PandaGuGu/stm32-health-monitor/board/schematic.md

# 接线与原理图

> 组件清单图见 [组件部分.png](./组件部分.png)；精修系统原理图见
> [docs/schematic/系统原理图_v1.1.svg](../docs/schematic/系统原理图_v1.1.svg)（[引脚分配表](../docs/schematic/系统原理图_v1.1.md)）。
> 本文件给出逐引脚接线表与一张供快速对照的 Mermaid 图。

## 1. 接线表

全部器件 **3.3V** 逻辑与供电，共地。

| 器件 | 引脚 | → STM32F103C8T6 | 备注 |
|---|---|---|---|
| **MAX30102** 心率血氧 | VCC | 3.3V | |
| | GND | GND | |
| | SCL | PB7 | 软件 I2C 时钟 |
| | SDA | PB8 | 软件 I2C 数据 |
| | INT | PB9 | 轮询（非中断）采样就绪 |
| **0.96" OLED** | VCC | 3.3V | SSD1306 |
| | GND | GND | |
| | SCK | PA5 | 软件 SPI/I2C 时钟 |
| | SDA | PA6 | 数据 |
| **MPU6050** 姿态 | VCC | 3.3V | |
| | GND | GND | |
| | SCL | PB10 | 硬件 I2C2 时钟 |
| | SDA | PB11 | 硬件 I2C2 数据 |
| **DS18B20** 温度 | VCC | 3.3V | |
| | GND | GND | |
| | DQ | PA8 | 单总线，需上拉 |
| **蜂鸣器**（有源） | VCC | 3.3V | |
| | GND | GND | |
| | I/O | PA12 | GPIO 高电平驱动 |
| **ESP32-WROOM-32** 信息节点 | VIN | 5V 或 3.3V | 板载 AMS1117，按模块实际标注接 |
| | GND | GND | 与 STM32 共地，串口通信的必要条件 |
| | GPIO16 (RX2) | ← PA9 | STM32 `USART1_TX` |
| | GPIO17 (TX2) | → PA10 | STM32 `USART1_RX` |

> **注意**：`PA12` 同时是 USB_DP。作 GPIO 使用后蓝板 USB 口不再用于 USB 通信（烧录用 SWD/JLINK 即可）。
> ESP32 只接三根线（TX / RX / GND），不共地时串口收到的全是乱码。

## 2. 系统连线（Mermaid）

```mermaid
flowchart LR
    subgraph Sensors["传感器 / 外设"]
        HR["MAX30102<br/>心率 · 血氧"]
        IMU["MPU6050<br/>姿态 · 跌倒"]
        TEMP["DS18B20<br/>体温"]
        BUZ["蜂鸣器<br/>报警"]
        LCD["0.96寸 OLED<br/>显示"]
    end

    subgraph MCU["STM32F103C8T6 蓝板"]
        I2C2["硬件 I2C2"]
        SWI["软件 I2C"]
        OW["1-Wire"]
        GPIO["GPIO"]
        POLL["INT 轮询"]
        U1["USART1<br/>PA9 / PA10"]
    end

    ESP["ESP32-WROOM-32<br/>信息节点"]

    HR -- "SCL=PB7 / SDA=PB8" --> SWI
    HR -- "INT=PB9" --> POLL
    IMU -- "SCL=PB10 / SDA=PB11" --> I2C2
    TEMP -- "DQ=PA8 + 4.7k 上拉" --> OW
    LCD -- "SCK=PA5 / SDA=PA6" --> SWI
    BUZ -- "I/O=PA12" --> GPIO
    U1 -- "TX/RX 115200<br/>GPIO16 / GPIO17" --> ESP
    ESP -- "BLE · WiFi · HTTP" --> NET(["App / 中继"])
```

## 3. 电源与信号完整性

- 供电：5V（USB/面包板）→ 蓝板 AMS1117 → **3.3V**，整机功耗约 50–80mA 典型，蜂鸣器按 20–30mA 计入，余量充足。
- 上拉：两条软件 I2C（PB7/PB8、PA5/PA6）与 DS18B20 DQ 需 4.7kΩ 上拉；多数成品模块已板载，**搭板前需核实**。
- 蜂鸣器若为无源（需 PWM 频率驱动），PA12 无定时器通道，需改接到 TIM 通道引脚（如 PA8/PA9/PA10 等），本工程按有源蜂鸣器编写。

## 4. 硬件搭建前确认清单

- [x] OLED 是 4 针(I2C) 还是 7 针(SPI)，驱动是否匹配 —— 实测为 I2C 模块，驱动匹配（`DST-015-D`，已加 ~2µs 底层延时后稳定）
- [x] 蜂鸣器有源/无源 —— 实测为**有源**（PA12 直接驱动，开机短鸣两声可闻）
- [x] 各模块板载上拉是否存在 —— MPU6050 有；OLED 有；MAX30102/DS18B20 待补（前者未接通、后者用内部 IPU 兜底）
- [ ] 蓝板晶振（8MHz HSE）与固件 `system_stm32f10x.c` 配置一致（本工程按 72MHz 主频）
