PandaGuGu/stm32-health-monitor/board/组件部分.png

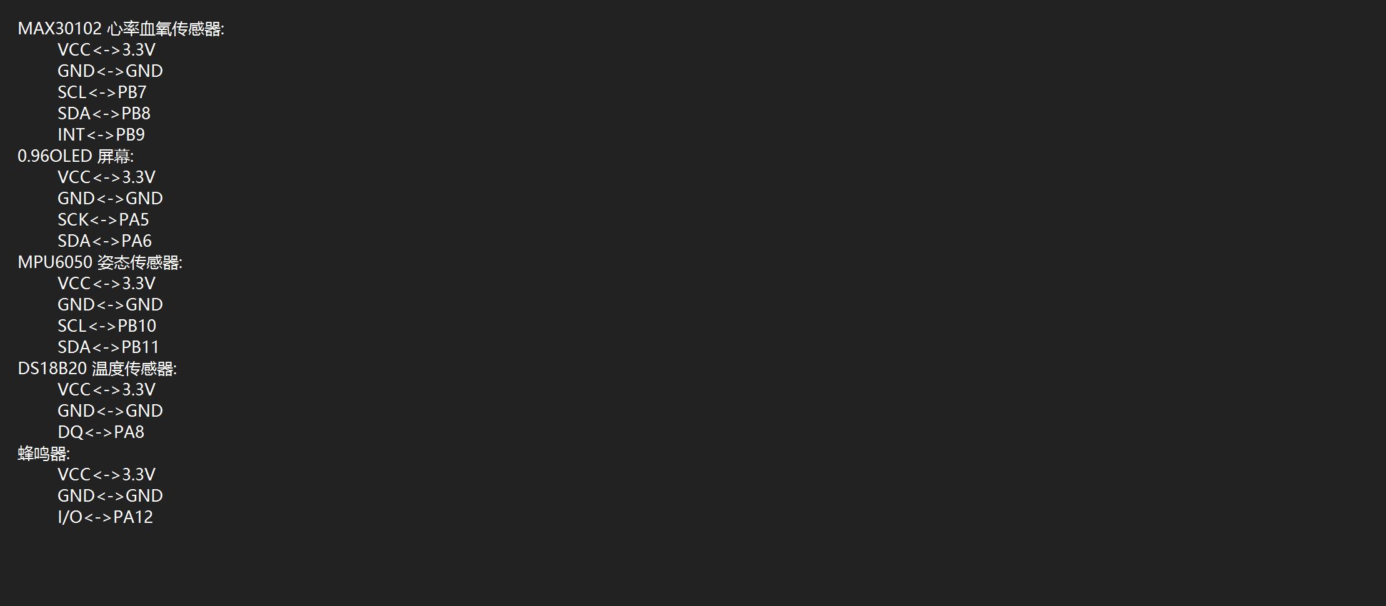
board/组件部分.png
