PandaGuGu/stm32-health-monitor/docs/esp32/app-mumu-1.png

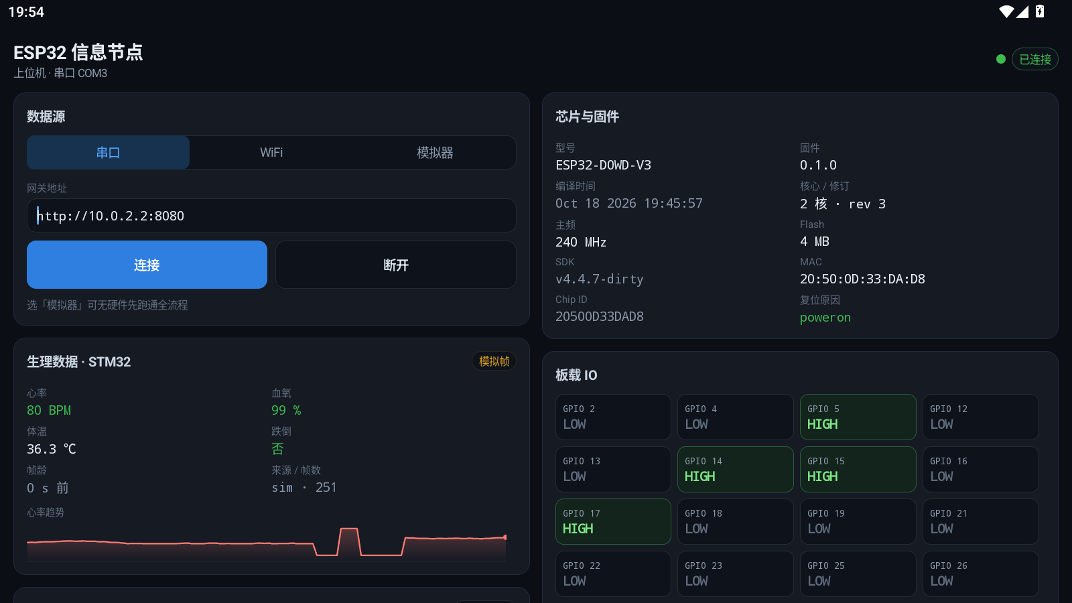
docs/esp32/app-mumu-1.png
