PandaGuGu/stm32-health-monitor/docs/esp32/app-mumu-2.png

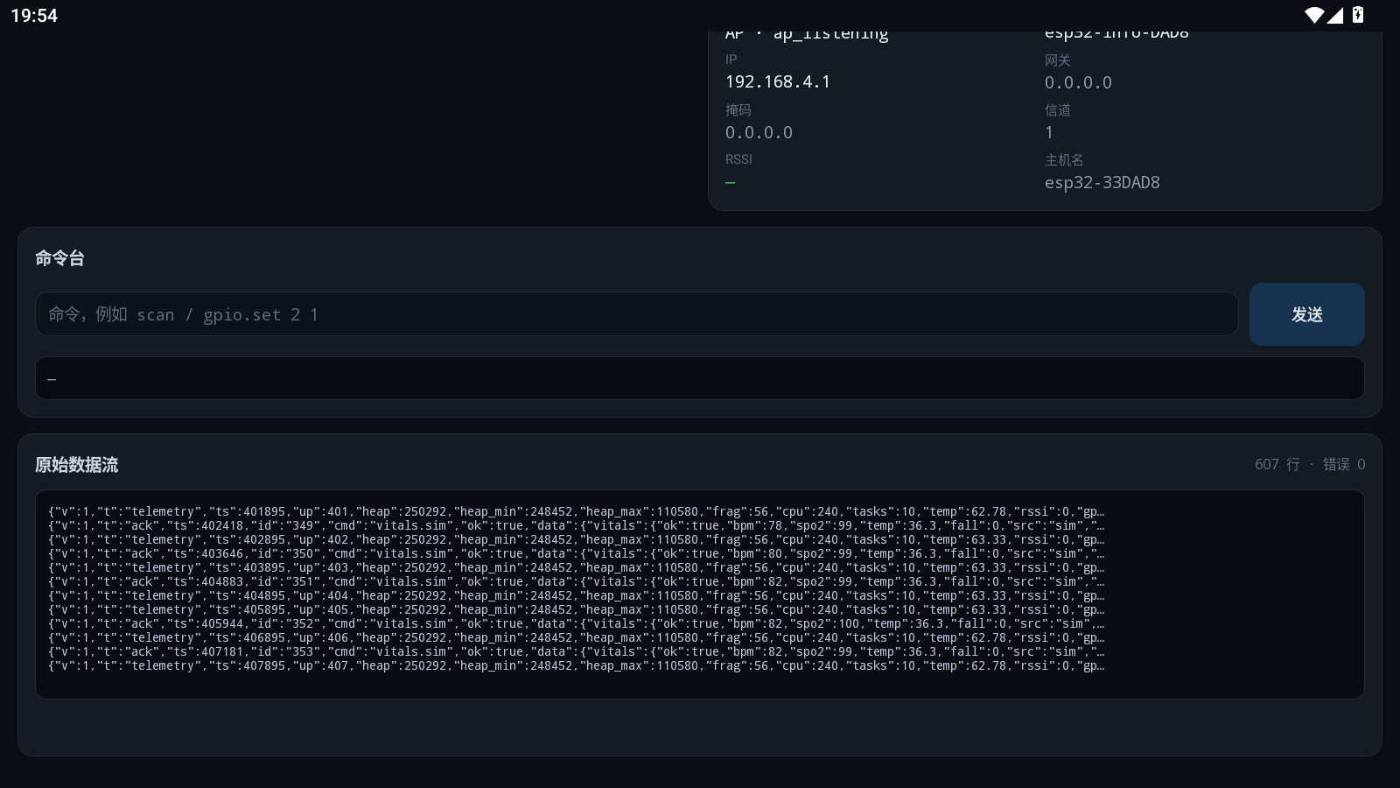
docs/esp32/app-mumu-2.png
