PandaGuGu/stm32-health-monitor/docs/esp32/app-mumu-wifi.png

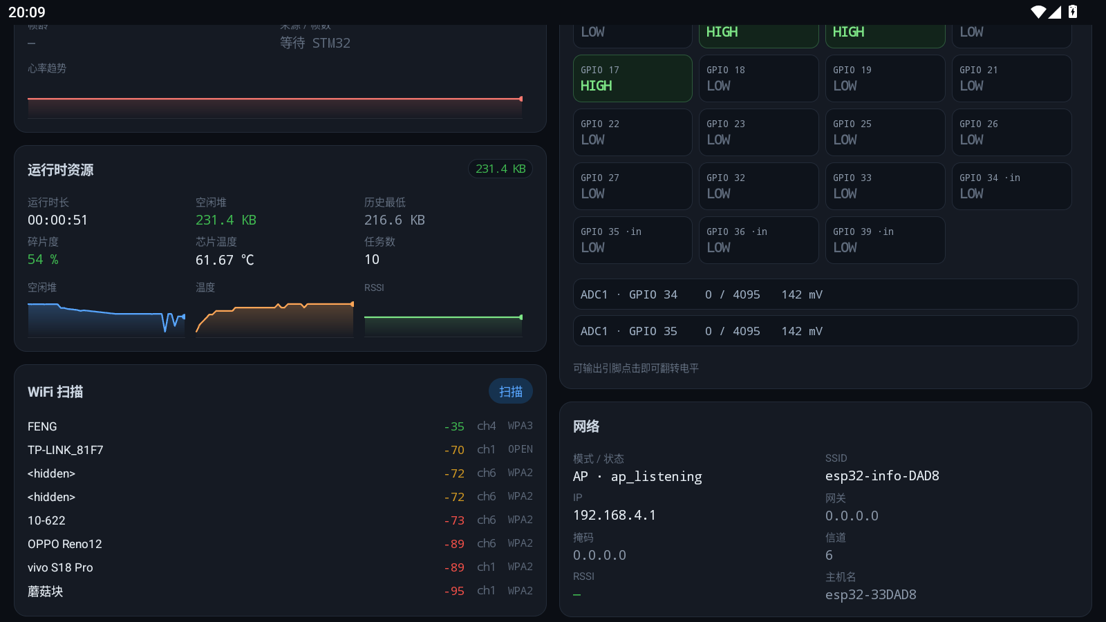
docs/esp32/app-mumu-wifi.png
