PandaGuGu/stm32-health-monitor/docs/esp32/web-dashboard.png

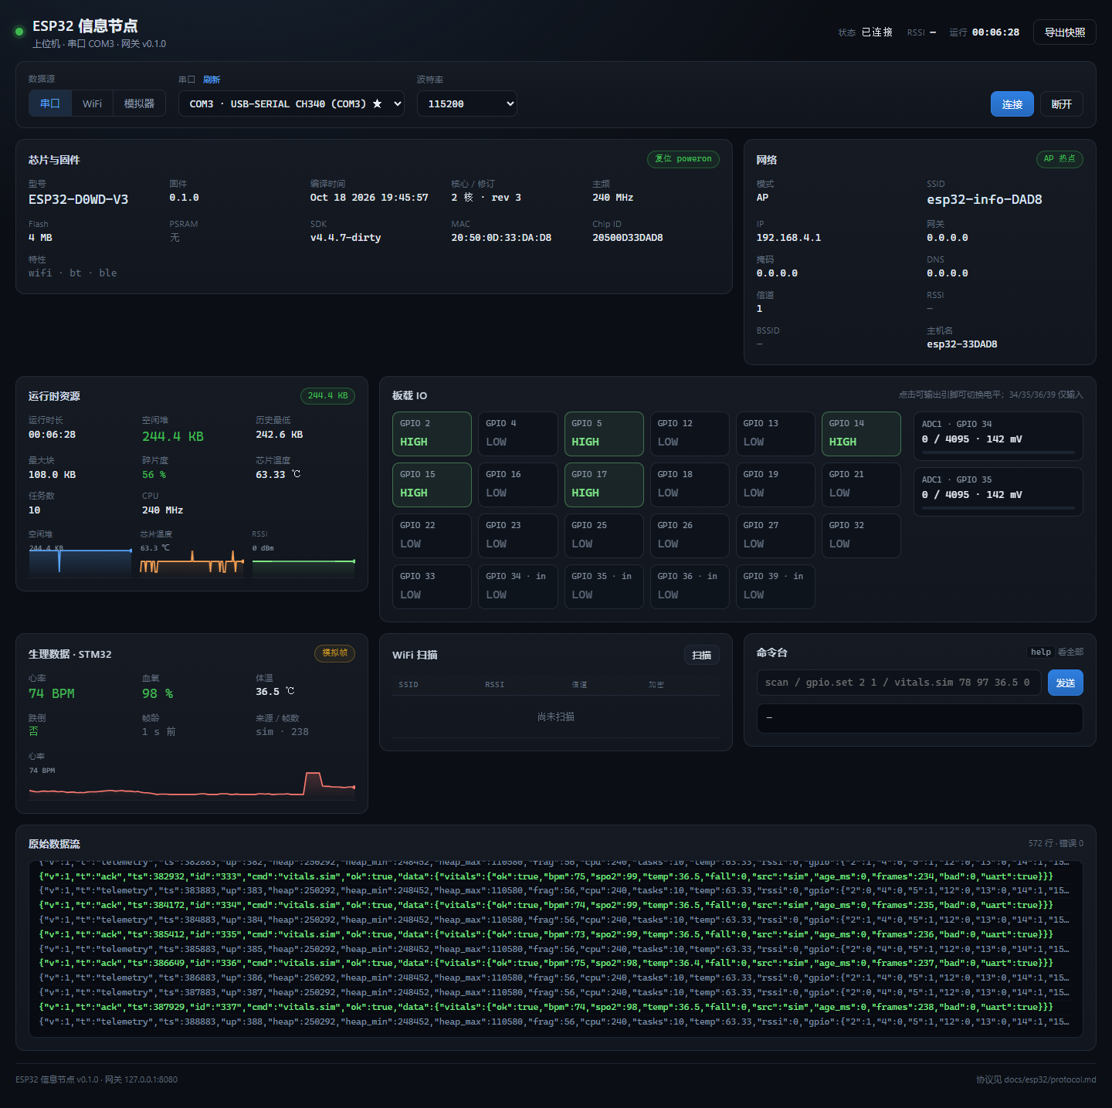
docs/esp32/web-dashboard.png
