PandaGuGu/stm32-health-monitor/docs/debug/README.md

# 调试与故障排查记录

本目录收录**STM32 侧**的硬件调试报告，全部基于**实机测量**（ST-Link + OpenOCD 直读寄存器/内存，非推断）。
每份报告都包含：现象 → 证据链 → 根因 → 修复动作 → 复现命令。

> ESP32 信息节点与上位机的调试记录不在本目录，见 [`../esp32/debug.md`](../esp32/debug.md)。
> 说明：报告中的本机绝对路径已脱敏为 `$HOME`（Git Bash）/ `%USERPROFILE%`（PowerShell）。

## 一、报告清单（按时间顺序）

| # | 报告 | 日期 | 核心结论 |
|---|---|---|---|
| 01 | [硬件调试报告](01-硬件调试报告.md) | 2026-10-13 | 固件烧录成功但卡死在 `ds18b20_init()`；定位到 `ds18b20.c:68` 无超时死等 |
| 02 | [引脚排查报告](02-引脚排查报告.md) | 2026-10-16 | SWD 打通（`adapter speed 20` 是唯一稳定档位）；建立 RC 电容探针法 |
| 03 | [元件复测报告](03-元件复测报告.md) | 2026-10-16 | 4 个元件（OLED / MPU6050 / DS18B20 / MAX30102）**全部实测通过** |
| 04 | [业务固件跑通报告](04-业务固件跑通报告.md) | 2026-10-16 | 黑屏根因是固件死等而非屏坏；业务功能实测跑通 |
| 05 | [全元件复测报告 v2.2](05-全元件复测报告_v2.2.md) | 2026-10-16 | **黑屏真因 = 扫描函数把 PA5/PA6 改成输入**（已修）；分模块对照确认各外设均已就绪 |
| 06 | [业务全功能跑通报告 v2.4](06-业务全功能跑通_v2.4.md) | 2026-10-16 | **全部业务功能实测跑通**。实测心率 **82 BPM**、血氧 **98%** |
| 07 | [跌倒判定优化报告 v2.5](07-跌倒判定优化_v2.5.md) | 2026-10-16 | **判定频率 0.52 Hz → 87.7 Hz（×166）**；判据由"单轴 2 s 差值"改为"合矢量 \|a\| 去重力偏差"（对翻转免疫）；阈值按实测数据定标为 **\|a\| 偏差 3072 LSB（≈2.5g）**；新增"连续 2 拍确认"与"全零样本剔除"。实测 hits/glitch/zero/err 全 0，静止时余量 ≈26 倍 |
| 08 | [PPG 信号质量门控与心率滤波 v2.6](08-PPG信号质量门控与心率滤波_v2.6.md) | 2026-10-16 | **修掉"检测不到了仍打印旧值"**：显示层原本无条件画 `dis_hr`/`dis_spo2`（拿不到新值就沿用旧值）。新增 5 项信号质量门控 **G1**（IR 直流 8000–250000 LSB、交流 ≥150 LSB、灌注指数 3–200‰、最新 0.5 s 接触检查）；`algorithm.c` 补心率生理门控 **30–220 bpm**；显示层做 **8 窗滑动 + 两级离群剔除**（输入级 2×门限拒收、显示级裁剪求平均）。实测：无手指 IR 直流仅 **490 LSB** 全部判无效；有手指 **心率 119 BPM / 血氧 97%** 正常出数 |
| 09 | [显示层保持与异常高亮 v2.7](09-显示层保持与异常高亮_v2.7.md) | 2026-10-16 | **显示行为改版**：① 取消 `S`/`~` 标记；② 由"失联即清屏"改为 **hold-last**——保持最后一次有效读数直到测到新值（失联时只清滑动窗，**不清** `app_hr_ok`/`app_hr_disp`）；③ 心率 <60 或 >100、血氧 <95%、跌倒"是" → **反色高亮**（**单色 SSD1306 物理上无红色像素**，用白底黑字替代），阈值可 SWD 在线改写；④ 修掉 `OLED_ShowChar`/`ShowChinese` **按位或**写入导致的**残影**。实测：松手后连续 15 个窗口纯暗电平（直流 580–720 LSB，门控失败 10 次），屏显仍保持 `心率 89 / 血氧 97%` 且高亮状态同步 |
| 10 | [仿真固件说明](10-仿真固件说明.md) | 2026-10-17 | **Proteus 仿真专用固件**：仿真器件与实物不等价（无 MAX30102/MPU6050、DS1822 模型读不通、MCU `CLOCK_SCALE=8`），另立 `firmware/MAX30102_sim/`；温度走 **RV2 电位器 ADC（PA0，15~45℃）**，心率用内置节律，跌倒由 SW3(PB1) 触发，屏上标 `POT`/`SIM`/`DS18` |

> 更早的同一支线迭代（`v1.0`–`v1.2` 引脚排查）已被 `02` 取代，未重复收录。

## 二、故障速查表

| 现象 | 根因 | 修复 |
|---|---|---|
| 烧录/校验成功，但 OLED 全黑、所有传感器读数恒为 0 | `ds18b20.c:68` 处 `while(READ_DQ)` 无超时死等，DS18B20 未应答即永久阻塞在 `ds18b20_init()` | ① DS18B20 的 DQ 补 4.7 kΩ 上拉；② 用带超时的 DS18B20 实现（见 `gcc/app/app_main.c`） |
| OpenOCD 报 `init mode failed`，100 kHz 以上连不上 | 杜邦线过长/无屏蔽，高频握手失败（信号完整性问题，非软件） | **`-c "adapter speed 20"`**（20 kHz 是实测唯一稳定档位） |
| ST-Link 报 `LIBUSB_ERROR_TIMEOUT` | 设备句柄卡死 | `Disable-PnpDevice` + `Enable-PnpDevice` 软件重枚举（无需拔插） |
| RC 探针读到 `PB3 = 3392` 异常大 | PB3 = JTDO，复位后被 JTAG 控制器接管，写 `CRH` 不生效 → 读数是 JTAG 时序伪影 | 忽略 PB3/PB4；任何 DIY 引脚复用都不要用这两脚 |
| `PA12` 检出"外部上拉"，误判蜂鸣器已接通 | PA12 兼作 USB_DP，板载 1.5 kΩ 上拉是**单片机自带**，与蜂鸣器无关 | 不能据此判定；以"开机短鸣两声"为准 |
| 诊断固件运行中 OLED 突然全黑（屏亮但无内容） | `periodic_scan()` 的 `pin_survey_port(GPIOA, ..., 0xE600, ...)` 不跳过 PA5/PA6，把 OLED 两根线重配成输入；而 `oled_show()` 只改 ODR 不改 `CRL` → 此后永久空写 | 每帧前调用 `oled_pins_fix()` 把 PA5/PA6 恢复为开漏输出（`GPIOA_CRL = 0x87788888`） |
| `adapter speed` 用 `hla_swd` 无效果 | OpenOCD 0.12 已删除 `hla_swd`，静默忽略该参数 | 用 0.11 或放弃 `hla_swd`，直接调 `adapter speed` |
| **轻触板子/抖动线材就报跌倒**，而真跌落反而不报 | 跌倒判定一圈只跑一次（1.9 s 一次，0.52 Hz）：真冲击只有几十 ms，整段落在两次判定之间被漏掉；而判据又是"上一圈 vs 这一圈"的单轴差值，2 s 内翻 15° 就能变化 500 LSB | ✅ **2026-10-16 已修（见 `07`）**：判定挂进两段纯等待提到 **87.7 Hz**，判据改为**合矢量 \|a\| 去重力偏差**（倾斜免疫），阈值定标为 3072 LSB（≈2.5g） |
| 传感器线被碰掉后，**跌倒报警永久点亮**、`app_fall_hits` 疯涨 | MPU 掉电后三轴全返回 `0x00` → `\|a\| = 0` → `dev = \|0-2048\| = 2048` **恰好等于旧阈值** → 每拍都判命中 | ✅ **已修**：全零突发样本直接丢弃（计入 `app_mpu_zero`），不参与判定 |
| **手指拿开后屏幕仍显示上一次的心率/血氧**，且数字看着正常 | ① 显示层无条件画 `dis_hr` / `dis_spo2`，没有新值就**沿用旧值**；② `algorithm.c` 对心率**无生理范围约束**，无手指时从暗电平（直流 490 LSB）里凑出"峰"，报 `ch_hr_valid=1 / 300 bpm`；血氧查表照样返回 99 | ✅ **2026-10-16 已修（见 `08`）**：算法层加 **30–220 bpm** 门控；信号层加 5 项质量门控（直流/交流/灌注指数/实时接触）；连续 2 窗失败清空滑动窗。⚠️ **注意 `09` 又改了显示策略**：门控失败不再清屏，而是**有意保持**最后一次有效读数（用户明确要求） |
| 屏幕数字由 3 位变 2 位时**残留一位残影**（`119` 之后显示 `89` 会看成 `889`）；"是/否"切换叠字 | `OLED_ShowChar` / `OLED_ShowChinese` 都是**按位或**写入显存，不清区域就会叠字 | ✅ **2026-10-16 已修（见 `09`）**：画数字前先 `OLED_ClearArea(47,16,24,16)` / `(47,32,24,16)`，"是/否"前 `OLED_ClearArea(80,48,16,16)` |
| **Proteus 仿真里蜂鸣器一声不响** | 元件被勾了 **`Exclude from Simulation`**——模型被剥离（`Element` 栏为空、`Show All` 后 `Other Properties` 仍空），IO 怎么拉都没用；另外 `Operating Voltage` 默认 12 V，3.3 V 电源轨抬不动 | 取消勾选；若模型已丢则删掉重放 `BUZZER`；`Operating Voltage` 改 **3.3**；检查 Windows 音量合成器里 Proteus 是否被静音（见 `10`） |
| 仿真中 DS18B20 读数恒为 `0xFFFF`（换算成 4095，屏显像 `95`） | 工程加载的是 **`DS1822.MDF`**：presence 正常但命令写不进器件，数据位全读到高电平。实测 48 组时序（开漏/推挽 × 6 组时隙 × 2 种输入模式 × 2 种命令重发）全部失败 | 换 Pro 自带 `DS18B20`/`DS1621` 模型，或改用 **RV2 电位器 → PA0 的 ADC**（见 `10`） |
| 仿真心率恒定（如 68）、改 CLOCK 频率也不跟着变 | Proteus MCU 模型 `CLOCK_SCALE=8`（≈64 MHz），而固件按 **72 MHz** 标定 → 所有延时偏 12.5%，1 Hz 被测成 888 ms → `60000/888 ≈ 68`；加上 OLED 刷屏阻塞 200~400 ms，轮询采样还会漏边沿 | `Clock Scale` 改 **9 Times**；仿真演示用心率节律（见 `10`） |
| Keil 授权不可用 / 无法编译 | — | 改用 arm-none-eabi-gcc 独立构建（见 [`gcc/README.md`](../../firmware/MAX30102/gcc/README.md)） |

### 已知的代码/文档不一致（调试中发现）

| 项 | 文档/宏 | 实际代码 | 影响 |
|---|---|---|---|
| DS18B20 上拉 | 文档要求 4.7 kΩ 外部上拉 | `ds18b20.c:45` 仅用内部 IPU（约 40 kΩ）兜底 | 长线/劣质模块下不足以拉高，建议补外部电阻 |

## 三、复现命令速查

```bash
export PATH="$HOME/tools/xpack-arm-none-eabi-gcc-14.2.1-1.1/bin:$PATH"
cd firmware/MAX30102/gcc

# 编译（变体见 gcc/README.md）：缺省 IIC / APP=1 / LIVE=1 / DIAG=1
SHELL=/usr/bin/bash /c/mingw/mingw64/bin/mingw32-make.exe -j4 APP=1

# 烧录（adapter speed 20 是关键）
openocd -f interface/stlink.cfg -f target/stm32f1x.cfg \
        -c "adapter speed 20" -c "init" -c "reset halt" \
        -c "program build/APP.elf verify" -c "reset run" -c "exit"

# 带电读回（自动解码 OLED 屏显 + PPG 质量门控 + 逐窗 trace）
python tools/ppg_read.py
```

## 四、当前状态

| 元件 | 引脚 | 状态 |
|---|---|---|
| OLED（0.96" SSD1306） | PA5 / PA6 | ✅ 实测通过 |
| MPU6050（姿态/跌倒） | PB10 / PB11 | ✅ `WHO_AM_I = 0x68` |
| DS18B20（体温） | PA8 | ✅ 应答 110 µs，读到 27 ℃ |
| 蜂鸣器 | PA12 | ✅ 已初始化，开机短鸣两声 |
| **MAX30102（心率/血氧）** | PB7 / PB8 / PB9 | ✅ 实测正常；门控后心率 **89–119 BPM**、血氧 **97%**；手指移开后屏显**保持最后一次有效读数**（按 `09` 的设计，不再回落 `---`） |

**全部业务功能已实测跑通**（`APP=1` 目标）：

```bash
make APP=1          # 完整业务固件
make APP=1 NOMAX=1  # 需要时：心率/血氧采集段屏蔽版
```

> 最新一轮（`06`）：MAX30102 早期曾无响应，已定位为**硬件接线问题**并解决；
> 全部业务功能实测跑通（心率 **82 BPM**、血氧 **98%**）。
>
> 跌倒判定（`07`）：判定频率 **87.7 Hz**，判据为**合矢量 \|a\| 偏离 1g 的偏差**，
> 门限 `app_fall_thresh = 3072 LSB（≈2.5g）`、确认拍数 `app_fall_need = 2`。
> 两个参数都在 RAM 里，**可用 SWD 在线改写，不用重烧**：
> ```bash
> openocd -f interface/stlink.cfg -f target/stm32f1x.cfg -c "adapter speed 20" -c "init" -c "halt" \
>         -c "mww 0x20000006 2048"   # 门限降到 2g（更灵敏）
>         -c "mww 0x20000004 3"      # 要求冲击持续 3 拍
>         -c "resume" -c "exit"
> ```
> ⚠️ 这些地址随固件重新编译会变，取址请现查：`arm-none-eabi-nm -S -n build/APP.elf | grep app_fall_`
>
> 心率 / 血氧门控（`08`）：新增 5 项信号质量判据 **G1**；`algorithm.c` 同时补了心率生理门控 **30–220 bpm**。
> 显示层为 **8 窗滑动 + 两级离群剔除**（输入级 2×门限拒收、显示级裁剪后求均值）。阈值：
> ```c
> APP_PPG_DC_MIN=8000   APP_PPG_DC_MAX=250000  APP_PPG_AC_MIN=150
> APP_PPG_PI_MIN=3      APP_PPG_PI_MAX=200
> APP_HR_MIN=30         APP_HR_MAX=220
> APP_SPO2_MIN=70       APP_SPO2_MAX=100       APP_LOSS_WINDOWS=2
> ```
>
> 显示策略与异常高亮（`09`）：**门控失败不再清屏**，改为 **hold-last**（保持最后一次有效读数直至测到新值）；
> 已取消 `S`/`~` 标记。⚠️ **这块 0.96" OLED 是单色 SSD1306，物理上没有红色像素** ——
> 异常用该屏能表达的最强形式 **反色高亮**（白底黑字）替代"标红"。
> 三个高亮阈值同样在 RAM 里、**可用 SWD 在线改写**（`0x20000004` 一个 32 位字打包三项）：
> ```bash
> openocd -f interface/stlink.cfg -f target/stm32f1x.cfg -c "adapter speed 20" -c "init" -c "halt" \
>         -c "mww 0x20000004 0x003c645f"   # [04]=spo2_warn_lo 95  [05]=hr_warn_hi 100  [06]=hr_warn_lo 60
>         -c "resume" -c "exit"
> ```
> ⚠️ 地址随重编译会变，取址现查：`arm-none-eabi-nm -S -n build/APP.elf | grep -E "app_hr_warn|app_spo2_warn"`
>
> 带电读回实测数据（自动解码 OLED 屏显 + 逐窗 trace）：
> ```bash
> python firmware/MAX30102/gcc/tools/ppg_read.py
> ```

## 五、Proteus 仿真

仿真**不是**实机，两者用的固件是分开的：

| | 固件 | 数据来源 |
|---|---|---|
| 实机 | `firmware/MAX30102/USER/main.c` | 全部真实传感器 |
| 仿真 | `firmware/MAX30102_sim/USER/main.c` | 温度=RV2 电位器（PA0 ADC），心率=内置节律，血氧=占位 97，跌倒=SW3(PB1) |

仿真工程 `sim/proteus/SIT_sim.pdsprj` 加载 `sim/proteus/IIC.hex`；改完仿真固件后需
重新编译并把 `firmware/MAX30102_sim/OBJ/IIC.hex` 复制到该路径。详细说明、引脚表与
"换回真传感器"的做法见 [`10-仿真固件说明.md`](10-仿真固件说明.md)。
