PandaGuGu/stm32-health-monitor/docs/debug/06-业务全功能跑通_v2.4.md

# STM32 健康监测仪 · 业务全功能跑通报告 v2.4

- 报告日期：2026-10-16
- 仓库：`PandaGuGu/stm32-health-monitor`
- 目标固件：`gcc` 下的 `APP` 目标（业务固件，完整功能）
- 芯片：STM32F103C8T6 蓝板
- **结论：MAX30102 工作正常，全部业务功能实测跑通。** ✅

---

## 一、结论先行

| 业务功能 | 引脚 | 实测证据 | 状态 |
|---|---|---|---|
| OLED 0.96" 显示 | PA5 / PA6 | 显存 427/1024 非零，8 页全覆盖 | ✅ |
| **MAX30102 心率** | PB7 / PB8 / PB9 | `ch_hr_valid=1`，`n_heart_rate=82` | ✅ |
| **MAX30102 血氧** | PB7 / PB8 / PB9 | `ch_spo2_valid=1`，`n_sp02=98` | ✅ |
| DS18B20 温度 | PA8 | `app_ds_ok=1`，presence 10µs，`Temp=31` | ✅ |
| MPU6050 姿态 | PB10 / PB11 | `AX=1397`，`AY=1510` | ✅ |
| 蜂鸣器（有源） | PA12 | 开机双响自检 | ✅ |
| 主循环活性 | — | 25s 内 `app_cycle=10`，无卡死 | ✅ |

MAX30102 早期曾无响应，已定位为**硬件接线问题**并解决；现已并入业务固件、正常出数。

---

## 二、实测数据（业务固件运行 25s 后 SWD 快照）

```
Temp=0x1F ch_hr_valid=0x01        -> 温度 31℃，心率有效
n_heart_rate = 0x52 = 82          -> 心率 82 BPM
ch_spo2_valid=0x01                -> 血氧有效
n_sp02 = 0x62 = 98                -> 血氧 98%

aun_red_buffer[0..3] = 640 640 637 632     <- 红光 ADC 真实波形（非零）
aun_ir_buffer [0..3] = 530 549 532 529     <- 红外 ADC 真实波形（非零）
n_ir_buffer_length   = 500                  <- 缓冲长度正确

app_ds_presence_us = 10   app_ds_ok = 1     <- DS18B20 应答正常
AX = 1397   AY = 1510                       <- MPU6050 有数据
app_cycle = 10                              <- 25s 跑 10 轮，主循环未卡死

OLED_DisplayBuf: 427/1024 非零，8 页 = [47,54,50,59,42,49,60,60]
```

心率 82 BPM、血氧 98% 是**真实测量值**（手指置于传感器上），说明 MAX30102 的光路、
ADC、FIFO、I²C 全链路都通了。

**生成器版回归复测**（同一固件重跑采样）：

| 次 | 心率 | 血氧 | 旁证 |
|---|---|---|---|
| 1 | 70 BPM（valid=1） | -999（本次未算出） | 红光 `43566→32358`、红外 `30853→22385`，脉动包络明显 |
| 2 | **96 BPM（valid=1）** | **97%（valid=1）** | 两项同时有效 |

> `n_sp02 = -999` 是 `algorithm.c` 在本次窗口内**未能算出**血氧时的哨兵值，不是故障；
> 同一固件下一次采样即得 97%。心率/血氧会随手指压力与运动波动，属正常现象。

---

## 三、可复现的交底

### 接线（与 sensor 丝印一一对应）

| 模块 | 引脚 |
|---|---|
| MAX30102 | VCC→3.3V，GND→GND，SCL→PB7，SDA→PB8，INT→PB9 |
| OLED | VCC→3.3V，GND→GND，SCK→PA5，SDA→PA6 |
| MPU6050 | VCC→3.3V，GND→GND，SCL→PB10，SDA→PB11 |
| DS18B20 | VCC→3.3V，GND→GND，DQ→PA8 |
| 蜂鸣器 | VCC→3.3V，GND→GND，I/O→PA12 |

### 构建与烧录

```bash
cd firmware/MAX30102/gcc
make APP=1            # 完整业务固件（含 MAX30102）
make APP=1 flash      # 编译 + OpenOCD 烧录
make APP=1 NOMAX=1    # 需要时：无 30102 关闭版
```

---

## 四、遗留与建议

1. **`max30102_init()` 里的 LED 电流是 7mA**（`LED1_PA=LED2_PA=0x24`）。若实测波形
   幅度偏小、心率不稳，可提高到 `0x3F`（约 12mA）或 `0x5F`（约 18mA）再试。
2. `algorithm.c` 有两条 `-Wmaybe-uninitialized` 警告（原工程既有），本轮未动。
3. `ds18b20.c` 的 `ds18b20_rst()` 仍有两处无超时 while；业务固件走的是 `app_main.c`
   里的本地 timeout-safe 驱动，不调用它，故无影响。若将来改用 `ds18b20.c`，需先补超时。
