PandaGuGu/stm32-health-monitor/docs/debug/01-硬件调试报告.md

# STM32 硬件调试报告 v1.0

> 归档说明：本文件来自项目调试记录（原始版本 **v1.0**，2026-10-13），收录时已把本机绝对路径脱敏为 `$HOME` / `%USERPROFILE%`。

**日期**：2026-10-13
**目标板**：STM32F103C8（64KB Flash / 20KB RAM），Device ID `0x20036410`
**调试器**：ST-Link V2J37S7（VID:PID 0483:3748）
**工具链**：arm-none-eabi-gcc 14.2.1 + OpenOCD 0.12.0（Keil 授权失效后改用 GCC）

---

## 一、结论（先行）

**固件烧录成功并运行，但卡死在初始化阶段——`ds18b20_init()` 里的死等循环，程序永远进不了主循环。**

这是**硬件侧问题**（DS18B20 未应答），不是固件构建问题。GCC 构建的固件本身完全正常。

---

## 二、烧录结果

| 项 | 结果 |
|---|---|
| OpenOCD 连接 | ✅ ST-Link 识别，目标电压 3.21V，Cortex-M3 r1p1 |
| 写入 | ✅ `Programming Finished` |
| 校验 | ✅ `Verified OK` |
| 复位后运行 | ✅ `msp: 0x20005000`（新固件栈顶）、`pc: 0x08001E20`（新固件复位入口） |

烧录前已备份芯片原固件 → `%USERPROFILE%\tools\flash_backup_orig.bin`（64KB）。

---

## 三、调试发现（GDB 调用栈）

附加 GDB 后暂停，调用栈如下：

```
#0  0x08000760  ds18b20_rst ()   ds18b20.c:68
#1  0x0800089a  ds18b20_init ()  ds18b20.c:234
#2  0x0800016c  main ()          main.c:88
```

多次采样 PC（8 次中 6 次）都落在 `0x08000756 ~ 0x08000760`，即 `ds18b20_rst()` 的**第一个等待循环**里，证明是**死循环**而非偶发。

---

## 四、根因分析

`HARDWARE/DS18B20/ds18b20.c` 第 61~70 行：

```c
void ds18b20_rst(void)
{
  mode_output();                              // PA8 输出
  GPIO_ResetBits(GPIOA, GPIO_Pin_8);          // 拉低 DQ
  delay_us(600);                              // 复位脉冲 600us
  GPIO_SetBits(GPIOA, GPIO_Pin_8);            // 释放
  mode_input();                               // PA8 输入上拉
  while(GPIO_ReadInputDataBit(GPIOA, GPIO_Pin_8));   // ← 第68行：无超时死等
  while(!GPIO_ReadInputDataBit(GPIOA, GPIO_Pin_8));
}
```

**第 68 行是无限循环，没有超时保护。** DS18B20 正常时应答时会拉低 DQ 60~240us，循环随即退出；若器件不存在/未接/接线错误，DQ 被内部上拉保持高电平，循环**永久卡死**。

实测旁证：
- 暂停时读 `GPIOA_IDR = 0x0000DFFF` → **PA8 = 1（始终高）**，从未出现过器件应答的低脉冲。
- `ds18b20_init()` 在第 234 行调用 `ds18b20_rst()`；main 在第 88 行调用 `ds18b20_init()`。

**因此 DS18B20 在 PA8 上没有应答。**

---

## 五、连锁影响

因为卡在 main 第 88 行（初始化早期），后续代码**全部未执行**：

| 行 | 未执行的初始化 | 现象 |
|---|---|---|
| 84 | `max30102_init()` | 心率/血氧始终 0 |
| 86 | `MPU6050_Init()` | 姿态数据 AX~GZ 始终 0 |
| 93 | `MPU6050_GetData()` | 同上 |
| 102~117 | 首次 500 点采样 + 算法 | `n_heart_rate`/`n_sp02` 始终 0 |
| 119~ | 主循环 | OLED 永远停在初始静态画面 |

所以「所有变量都是 0」不是算法 bug，而是**根本没跑到**。

---

## 六、DS18B20 接线核对（据 main.c 注释）

| 信号 | 引脚 |
|---|---|
| DQ | **PA8** |
| VCC | 3.3V（**勿接 5V**） |
| GND | GND |
| 上拉 | DQ 与 3.3V 之间建议接 **4.7kΩ** 外部上拉 |

代码仅依赖 STM32 内部上拉（IPU，约 40kΩ），长线或劣质模块可能不足，建议补外部 4.7kΩ。

---

## 七、下一步选项

1. **检查/接好 DS18B20**（首选）——接对线后重启即应进入主循环。
2. **给死等循环加超时保护**——让缺传感器时固件仍能运行（需修改仓库源码 `ds18b20.c`，属于对方工程，需确认）。
3. **临时跳过 DS18B20 初始化**——先验证 MAX30102 / MPU6050 / OLED，同样需改源码。

---

## 附：调试环境

```bash
# 终端1：启动 GDB server
cd firmware/MAX30102/gcc
make OPENOCD_BIN=$HOME/tools/xpack-openocd-0.12.0-7/bin debug-server

# 终端2：附加调试
export PATH="$HOME/tools/xpack-arm-none-eabi-gcc-14.2.1-1.1/bin:$PATH"
arm-none-eabi-gdb build/IIC.elf -x debug.gdb
# (gdb) bt          看调用栈
# (gdb) info locals 看局部变量
# (gdb) c           继续运行
```
