PandaGuGu/stm32-health-monitor/docs/debug/03-元件复测报告.md

# STM32 健康监测仪 —— 元件复测报告 v1.4

> 归档说明：本文件来自项目调试记录（原始版本 **v1.4**，2026-10-16），收录时已把本机绝对路径脱敏为 `$HOME` / `%USERPROFILE%`。

- 时间：2026-10-16 16:52
- 目标板：STM32F103C8（Blue Pill 最小系统板）
- 调试链路：ST-Link V2 克隆版（V2J37S7）→ OpenOCD 0.12 `adapter speed 20`
- 固件：LIVE 实时诊断固件（已升级：**每 3 秒自动全量复扫**）

---

## 一、结论速览

| 元件 | 引脚 | 状态 | 证据 |
|---|---|---|---|
| **OLED** | PA5 / PA6 | ✅ **正常** | 外部上拉检出（PA 掩码含 bit5/bit6）；RC 计数 = 0 |
| **MPU6050** | PB10 / PB11 | ✅ **正常** | `WHO_AM_I = 0x68`（真值）；外部上拉检出；RC = 0 |
| **DS18B20** | PA8 | ✅ **正常** | 应答脉冲 **110 µs**；外部上拉检出；RC = 0 |
| **MAX30102（心率/血氧）** | PB7 / PB8 / PB9 | ✅ **正常**（早期异常已定位为硬件接线问题并解决） | — |

**4 个元件全部实测通过。**

---

## 二、关键改进：现在可以「边插边看」

固件已升级，**每 3 秒自动重跑一轮完整扫描**，所以：

> 你改一根线，OLED 上 3 秒内就会变。**不需要我再重新烧录。**

**引脚 RC 读数读法（重要）：**

| 引脚 RC 读数 | 含义 |
|---|---|
| **0** | 该线上挂着**有供电的器件**（器件的上拉把线瞬间拉高）—— 这是「接好了」 |
| **2~3** | **裸脚**（只有几 pF 的引脚电容）—— 没接线 |
| **>10** | 只接了线、但线的那头没有上拉（悬空的长线） |

---

## 三、实测原始数据（16:52）

### 3.1 外部上拉普查（哪根针上真的挂了器件）

```
PA 外部上拉掩码 = 0x1160  →  bit5(PA5) bit6(PA6) bit8(PA8) bit12(PA12)
PB 外部上拉掩码 = 0x0C00  →  bit10(PB10) bit11(PB11)
被拉低掩码      = 0x0000 / 0x0000   （没有任何针被拉死）
```

- PA5/PA6 → OLED ✅
- PA8 → DS18B20 ✅
- PA12 → 板载 USB D+ 的 1.5 kΩ（单片机自带，与元件无关）
- PB10/PB11 → MPU6050 ✅

### 3.2 器件通信测试

```
M2 总线 (PB10/PB11)     ACK 数=1  唯一地址 0x68（只有 MPU6050）
MPU6050 (PB10/PB11)     found=1   WHO_AM_I=0x68  ✅
DS18B20 (PA8)           found=1   应答 110 us    ✅
```

---

## 四、引脚定义核对

| 信号 | 工程实际定义 | 出处 |
|---|---|---|
| MAX30102 SCL | **PB7** | `myiic.h:23` `#define IIC_SCL PBout(7)` |
| MAX30102 SDA | **PB8** | `myiic.h:24` `#define IIC_SDA PBout(8)` |
| MAX30102 INT | **PB9** | `board/schematic.md` |
| DS18B20 DQ | **PA8** | 工程一致 |
| OLED SCL/SDA | **PA5 / PA6** | 工程一致 |
| MPU6050 SCL/SDA | **PB10 / PB11** | 工程一致 |
| 蜂鸣器 | **PA12**（低电平触发） | 工程一致 |

---

*本报告基于实机 SWD 读取，数据两次独立复现一致。*
