PandaGuGu/stm32-health-monitor/docs/debug/05-全元件复测报告_v2.2.md

# STM32 全元件复测报告 v2.2

- **时间**：2026-10-16 19:30 左右
- **对象**：STM32F103C8T6 最小系统板 + 5 个外设
- **方法**：ST-Link SWD（OpenOCD，`adapter speed 20`，实际回落 15 kHz）烧录实时诊断固件
  `make LIVE=1`，`reset run → sleep 6 s → halt` 后直读 RAM 结构 `live`（`0x20000060`，288 B）
- **本轮新增**：黑屏根因定位与修复闭环
- **性质**：**三次独立上电采样，数据完全一致**；不采信任何口头结论

---

## 一、结论速览

| 元件 | 关键引脚 | 期望 | 实测 | 判定 |
|---|---|---|---|---|
| OLED 0.96" (SSD1306) | PA5 / PA6 | I2C 可写 | `GPIOA_CRL=0x87788888`（PA5/PA6 = 开漏输出），显存 480/1024 非零、8 页全有内容 | ✅ |
| MPU6050 | PB10 / PB11 | `WHO_AM_I=0x68` | `mpu_id=0x68`，`bus2_cnt=1` | ✅ |
| DS18B20 | PA8 | 有应答脉冲 | `ds_found=1`，应答 **110 µs** | ✅ |
| 蜂鸣器（有源） | PA12 | 可驱动 | 推挽拉高/拉低回读均正常 | ✅ |
| **MAX30102（心率/血氧）** | PB7 / PB8 / PB9 | `PART_ID=0x15` | `PART_ID=0x15` | ✅（早期异常已定位为硬件接线问题并解决） |

**全部外设实测通过。**

---

## 二、黑屏：根因与修复（已闭环）

### 根因

`periodic_scan()` 里的 `pin_survey_port(GPIOA, "PA", 0xE600, ...)` **不跳过 PA5 / PA6**，
把 OLED 的两根线重配成输入模式；而 `oled_show()` **只改 ODR、不重写 CRL**，
于是从第一次扫描之后就永久空写 —— 屏是亮的，但内容永远是 `OLED_Init()` 留下的全清画面。

**证据（修复前）**：`GPIOA_CRL = 0x88888888`，PA5/PA6 nibble = `0x8`（输入下拉，锁死）。
**对照**：MPU6050 的 PB10/PB11 在 `bb_scan` 后每一步都重新 `GPIO_Init`，所以不受影响。

### 修复

在 `diag_live.c` 新增 `oled_pins_fix()`，`oled_show()` 第一行调用，每帧把 PA5/PA6
恢复成开漏输出并释放为高：

```c
static void oled_pins_fix(void)
{
    GPIO_InitTypeDef g;
    g.GPIO_Pin   = GPIO_Pin_5 | GPIO_Pin_6;
    g.GPIO_Speed = GPIO_Speed_50MHz;
    g.GPIO_Mode  = GPIO_Mode_Out_OD;
    GPIO_Init(GPIOA, &g);
    GPIO_SetBits(GPIOA, GPIO_Pin_5 | GPIO_Pin_6);
}
```

### 验证（本轮实测）

| 项目 | 修复前 | 修复后 |
|---|---|---|
| `GPIOA_CRL` | `0x88888888`（PA5/PA6 = 输入下拉） | **`0x87788888`**（PA5/PA6 = 开漏输出 50 MHz） |
| OLED 显存非零字节 | 0 / 1024 | **480 / 1024** |
| 分页分布（8 页） | 全 0 | **60 / 68 / 39 / 75 / 55 / 62 / 58 / 63** |

> 注：同一时刻 `GPIOB_CRL = 0x88888888`（PB7 处于输入态）属正常 —— 那是 `periodic_scan()`
> 的收敛状态，OLED 只依赖 PA5/PA6，不受影响。

---

## 三、原始数据（`live` 结构解码，3 轮独立采样）

> 结构体从 v2.1 的 172 B 扩到 **288 B（0x120）**；
> 已有字段偏移不变，`live` 基址恒为 `0x20000060`，`OLED_DisplayBuf` 移到 `0x20000250`。

| 字段 | 轮1 | 轮2 | 轮3 | 含义 |
|---|---|---|---|---|
| `magic` | `0x4C495645` | 同 | 同 | "LIVE"，固件在跑 |
| `cycle` | 6 | 6 | 6 | 循环在增长，未卡死 |
| `pin_hi[0..7]` | 全 1 | 全 1 | 全 1 | 8 根脚推挽拉高都能读回高 ✅ |
| `pin_lo[0..7]` | 全 0 | 全 0 | 全 0 | 8 根脚最终都能拉低 |
| `surv_pu_a` | `0x1160` | 同 | 同 | PA5/PA6/PA8/PA12 有外部上拉 |
| `surv_pu_b` | `0x0F80` | 同 | 同 | PB7/PB8/PB9/PB10/PB11 有外部上拉 |
| `surv_lo_a` / `surv_lo_b` | `0x0000` / `0x0000` | 同 | 同 | 全板无被拉低的脚，**无对地短路** |
| `mpu_found` / `mpu_id` | 1 / `0x68` | 同 | 同 | MPU6050 正常 ✅ |
| `ds_found` / `ds_us` | 1 / **110** | 同 | 同 | DS18B20 正常 ✅ |
| `ds_scan_pa` | `0x0100` | 同 | 同 | DS18B20 确实在 PA8 |
| `bus2_cnt` / `bus2_addr[0]` | 1 / `0x68` | 同 | 同 | PB10/PB11 上只有 MPU6050 |
| `all_ok` | 1 | 1 | 1 | 全部就绪 |

---

## 四、附：当前芯片内的固件

- 芯片里现在烧的是 **LIVE 实时诊断固件**（`build/LIVE.elf`，text 20608 / data 96 / bss 3392）。
- 恢复业务固件：`make APP=1 flash`。

---

*本报告由独立测量数据生成；`docs/debug/` 下同步归档。*
