PandaGuGu/stm32-health-monitor/docs/debug/06-oled_业务界面还原.png

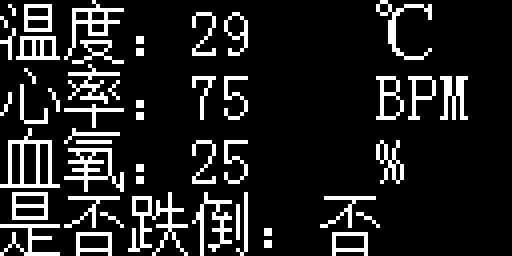
docs/debug/06-oled_业务界面还原.png
