PandaGuGu/stm32-health-monitor/(list of files, drawings)

Other design files:
sim/proteus/SIT_sim.pdsprj
