PandaGuGu/stm32-health-monitor/firmware/esp32/esp32_info_node/config.h

// ============================================================
// config.h — ESP32 信息节点 · 编译期配置
// 引脚策略 / 上报周期 / AP 兜底参数都在这里，改完重新编译即可
// ============================================================
#pragma once
#include <Arduino.h>

#define FW_NAME         "esp32-info-node"
#define FW_VERSION      "0.1.0"
#define PROTO_VERSION   1

// ---- 串口 ----
#define SERIAL_BAUD     115200

// ---- 遥测 ----
#define DEFAULT_INTERVAL 1000      // 默认 1 Hz
#define MIN_INTERVAL     100
#define MAX_INTERVAL     60000

// ---- AP 兜底（NVS 里没有 WiFi 凭据时启用；也可用 wifi.ap 命令主动切换）----
#define AP_PREFIX        "esp32-info-"
#define AP_PASS          "12345678"   // >= 8 位，否则起不来
#define AP_CHANNEL       6
#define HTTP_PORT        80

// ---- NVS ----
#define NVS_NS           "info_node"

// ---- 上电默认采样的 ADC 引脚（ADC1；ADC2 与 WiFi 冲突，不开放）----
#define DEFAULT_ADC_PINS { 34, 35 }

// ---- 板载 LED ----
#define LED_PIN          2

// ---- 与 STM32 的数据链路（UART2 ↔ STM32 USART1）----
// 接线：STM32 PA9(TX) → ESP32 GPIO16(RX)；STM32 PA10(RX) ← ESP32 GPIO17(TX)；共地
#define VITALS_RX_PIN    16
#define VITALS_TX_PIN    17
#define VITALS_BAUD      115200
#define VITALS_STALE_MS  8000     // STM32 主循环 ~5-6 s 才发一帧，留 2 s 余量

// ---- 蓝牙（可选，默认关闭）----
// 置 1 才编译 BLE 外设：手机就近用 BLE 收 vitals，不需要 WiFi。
// 与 WiFi 可共存，但射频分时，两边吞吐都会下降。
// 也可在编译命令行覆盖：-DENABLE_BLE=1
#ifndef ENABLE_BLE
#define ENABLE_BLE         0
#endif
#define BLE_NAME           "stm32-vitals"   // 广播名，后面自动拼 MAC 后四位
#define BLE_MTU            517              // 本地支持的上限，实际值由手机协商决定
#define BLE_NOTIFY_MS      2000             // 无新帧时的兜底推送间隔
