PandaGuGu/stm32-health-monitor/firmware/MAX30102_sim/SYSTEM/timer/timer.c

#include "timer.h"
#include "stm32f10x.h"                  // Device header

extern u8 flag1s;

/////////////////////////////////////////////////////////////////////////////////////////////////////////// 
//
//以下内容主函数定时标志位设置所用 定时1ms  10-1 7200-1
//
/////////////////////////////////////////////////////////////////////////////////////////////////////////// 

void TIM3_Int_Init(u16 arr,u16 psc)
{
	TIM_TimeBaseInitTypeDef TIM_TimeBaseInitStructure;
	NVIC_InitTypeDef NVIC_InitStructure;
	
	RCC_APB1PeriphClockCmd(RCC_APB1Periph_TIM3,ENABLE);		//使能TIM3时钟
	
	TIM_TimeBaseInitStructure.TIM_Period		=	arr;	//初始化定时器3
	TIM_TimeBaseInitStructure.TIM_Prescaler		=	psc;
	TIM_TimeBaseInitStructure.TIM_CounterMode	=	TIM_CounterMode_Up;
	TIM_TimeBaseInitStructure.TIM_ClockDivision	=	TIM_CKD_DIV1;
	TIM_TimeBaseInit(TIM3,&TIM_TimeBaseInitStructure);
	
	TIM_ITConfig(TIM3,TIM_IT_Update,ENABLE);				//允许定时器3更新中断
	
	NVIC_InitStructure.NVIC_IRQChannel 						=	TIM3_IRQn;	//初始化NVIC
	NVIC_InitStructure.NVIC_IRQChannelPreemptionPriority	=	0x01;
	NVIC_InitStructure.NVIC_IRQChannelSubPriority			=	0x03;
	NVIC_InitStructure.NVIC_IRQChannelCmd 					=	ENABLE;
	NVIC_Init(&NVIC_InitStructure);
	
	TIM_Cmd(TIM3,ENABLE);									//使能定时器3
}
