PandaGuGu/stm32-health-monitor/firmware/MAX30102_sim/HARDWARE/OLED/OELD_Data.h

#ifndef __OLED_DATA_H
#define __OLED_DATA_H

#include <stdint.h>

/*????????*/
#define OLED_CHN_CHAR_WIDTH			3		//UTF-8?????3,GB2312?????2

/*??????*/
typedef struct 
{
	char Index[OLED_CHN_CHAR_WIDTH + 1];	//????
	uint8_t Data[32];						//????
} ChineseCell_t;

/*ASCII??????*/
extern const uint8_t OLED_F8x16[][16];
extern const uint8_t OLED_F6x8[][6];

/*????????*/
extern const ChineseCell_t OLED_CF16x16[];

/*??????*/
extern const uint8_t Diode[];
/*???????,???????????????*/
//...

#endif


/*****************????|????****************/
/*****************jiangxiekeji.com*****************/
