PandaGuGu/stm32-health-monitor/(commit log)

2026-09-16 feat: STM32 健康监测(心率/血氧/体温/跌倒) 仓库骨架 + 正点原子SPL固件
2026-09-16 docs: README 补 Mermaid 接线图，architecture 增 TODO 待办清单
2026-09-16 fix(mermaid): 移除接线图标签中转义引号，改用'0.96寸'避免解析错误
2026-10-09 fix(oled): SCL/SDA 底层加 ~2µs 延时，解决 DST-015-D 模块 I2C 丢位黑屏
    [OLED.c]
2026-10-16 feat(gcc): 新增 arm-none-eabi-gcc 构建系统（替代 Keil）+ 诊断/业务固件
    Keil 授权不可用后，提供一套独立于 Keil 的 GCC 构建路径，产出 .elf/.hex/.bin。
    目录内容：
    - Makefile / STM32F103C8.ld / startup_stm32f10x_md_gcc.s GCC 构建骨架
    - diag/diag_main.c 一次性诊断固件
    - diag/diag_live.c 实时诊断固件（每 3 秒全量复扫，可边接线边看）
    - app/app_main.c 业务固件 MAX30102 关闭版
    - app/make_app.py 从 USER/main.c 字节级派生 app_main.c（GBK 安全）
    - debug.gdb GDB 调试脚本（断点停在各传感器初始化）
    四种构建变体：缺省 IIC / APP=1 / LIVE=1 / DIAG=1。
    APP=1 规避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
2026-10-16 docs(debug): 归档 5 份硬件调试报告 + 故障速查表
    收录实机调试记录（基于 ST-Link/OpenOCD 直读寄存器与内存，非推断）：
    - 01-硬件调试报告(v1.0) 固件卡死 ds18b20_init() 的调用栈定位
    - 02-引脚排查报告(v1.3) SWD 打通；adapter speed 20；RC 电容探针法
    - 03-元件复测报告(v1.4) 4 元件 3 通过，仅 MAX30102 无电气痕迹
    - 04-MAX30102专项诊断(v1.5) 四项独立测量交叉印证 PB7/PB8 无连接
    - 05-业务固件跑通报告(v2.0) 黑屏根因是死等；除 MAX30102 外全部跑通
    另附 docs/debug/README.md：报告索引 + 故障速查表（现象→根因→修复）
    + 三处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
2026-10-16 docs: 补调试记录/GCC 构建交叉引用，修正 INT 引脚不一致说明
    - README：目录结构补 docs/debug 与 gcc/；新增「硬件调试记录」小节；
    快速开始拆成 Keil(方式A)/GCC(方式B) 两条路径；
    MAX30102 INT 脚加脚注说明代码内部矛盾（宏读 PB9 / 初始化 PB14）
    - board/schematic.md：INT 行加同一条脚注；搭建前确认清单勾选已核实项
    （OLED 为 I2C 模块、蜂鸣器为有源、上拉现状）
    - docs/architecture.md：构建章节补 GCC 路径；已知注意点补三处无超时死等
    的位置表、INT 引脚矛盾、SDA_IN 浮空问题；新增「调试记录」章节；
    TODO 补 MAX30102 接线复核与 INT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
2026-10-16 fix: 清理 main.c 未使用的 temp_num / str，编译告警归零
    原工程编译残留 2 个告警（`temp_num`、`str` 声明后从未被引用），
    即 docs/architecture.md TODO 中「消除编译告警」一项。
    - USER/main.c 删除两个未使用变量声明（-2 行，纯声明清理，无功能改动）
    - gcc/app/app_main.c 由 app/make_app.py 字节级重新派生，保持同源一致
    - README.md 编译结果 0 Error, 2 Warning -> 0 Error, 0 Warning
    - docs/architecture.md 同步构建结论；TODO「消除编译告警」勾选完成
    复验：`make`（GCC 缺省目标）main.c 零告警，IIC 构建通过 ——
    FLASH 11124B(16.97%) / RAM 12792B(62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
2026-10-16 feat(firmware): MAX30102 全功能接入 + PPG 信号质量门控；docs: 调试记录重整归档
    固件
    - max30102.c: INT 引脚由 PB14 修正为 PB9（myiic.h:6 实际轮询的是 PBin(9)），
    配为输入上拉；文件仍保持 GBK 编码，新增注释全部 ASCII
    - algorithm.c: 补心率生理范围门控 30–220 bpm（IEC 60601-2-27），
    并消除 n_y_dc_max_idx / n_x_dc_max_idx 的 -Wmaybe-uninitialized 告警
    - gcc/app: PPG 5 项信号质量门控（IR 直流 8000–250000 LSB、交流 ≥150 LSB、
    灌注指数 3–200‰、最新 0.5 s 接触检查）；8 窗滑动 + 两级离群剔除；
    门控失败保持最后一次有效读数；异常值反色高亮（心率<60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
2026-10-17 docs(schematic): 新增系统原理图（精修 SVG + 引脚分配表）
    - docs/schematic/系统原理图_v1.0.svg：1400x920 矢量，学术排版——
    图题、图例、器件位号（U1-U6 / BZ1 / J1 / P1）齐全，分区底色保证灰度
    打印可辨；样式全部内联，避免 GitHub 对 SVG 做 sanitize 时剥离 style
    导致排版漂移
    - docs/schematic/系统原理图_v1.0.md：正文只保留精修图与引脚分配表，
    附注说明软件 I2C / 硬件 I2C2 / 1-Wire 的差异
    - 引脚按 HARDWARE 层实际配置核实：OLED PA5/PA6（Out_OD）、MPU6050
    PB10/PB11（AF_OD）、MAX30102 PB7/PB8 与 INT PB9、DS18B20 PA8、
    蜂鸣器 PA12
    - README 与 docs/architectu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
2026-10-17 feat(sim): 加入 Proteus 仿真工程(SIT_sim.pdsprj+仿真固件IIC.hex)与 Wokwi 方案，并排除自动备份/会话文件
2026-10-17 feat(sim): 仿真专用固件 v10 —— 温度/心率模拟 + 跌倒开关 + 蜂鸣器
    Proteus 工程里缺少 MAX30102、MPU6050，DS18B20 加载的是 DS1822 模型，
    且 MCU 模型 CLOCK_SCALE=8(≈64MHz) 与固件假设的 72MHz 不符，原固件在仿真中
    会卡在 MAX30102 中断等待，或读回 0xFFFF。为此新增独立的仿真工程副本：
    - firmware/MAX30102_sim/：仿真专用工程，USER/main.c 重写
    * 上电自动扫描 48 组单总线时序（开漏/推挽 × 6 组时隙 × 2 种输入模式 ×
    2 种命令重发），用配置寄存器特征位判定是否读通
    * 读不通时自动降级为模拟温度：25→38℃，每秒 1℃，来回循环
    * 心率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
2026-10-17 feat(sim): 温度接入 RV2 电位器（PA0/ADC1_IN0），0~3.3V 映射 15~45℃
    - 新增 pot_adc_init()/pot_adc_read()：直接操作 ADC1 寄存器实现
    （工程未编译 stm32f10x_adc.c，改用寄存器访问，避免改动 Keil 工程）
    采样时间 55.5 周期，ADCCLK=12MHz，转换带超时保护，超时按"未接"处理
    - 温度优先级：DS18B20(若单总线扫描成功) > RV2 电位器 ADC > 软件模拟
    - 屏幕来源标记扩展为 DS18 / POT / SIM
    - 电位器读数 >40 才认定通道有效，避免悬空时误判；一旦确认就全程使用
    - 文档同步更新
2026-10-17 feat(sim): 温度显示改为一位小数（0.1℃ 分辨率）
    15~45℃ 全量程映射下，1% 电位器变化只有 0.3℃，整数显示几乎看不到变化。
    改为 temp10（0.1℃ 单位）后转电位器能立刻看到数字变化。
    模拟温度同样走 temp10，DS18B20 分支按 raw*10/16 换算。
2026-10-17 docs: 整理 README / 架构 / 调试索引，补全 Proteus 仿真章节
    README.md
    - 目录结构补入 firmware/MAX30102_sim（实物/仿真双固件）与 sim/proteus、sim/wokwi
    - 新增「仿真（Proteus）」章节：为什么单独一份固件、仿真数据源与引脚表、
    POT/SIM/DS18 来源标记、编译与部署命令
    - 调试记录摘要补入仿真的三类坑，报告数 9 → 10
    docs/architecture.md
    - 目录职责后补充「仿真变体」说明：同一套工程副本，只替换 USER/main.c，
    与实物固件互不覆盖
    docs/debug/README.md
    - 报告清单新增 #10（仿真固件说明）
    - 故障速查表新增 3 条：蜂鸣器 Exclude from Simulation、DS1822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
2026-10-17 docs: 增加 About 与徽章，补充 CHANGELOG 与 v0.0.1 发布说明
    - README 顶部加徽章：Release / 最近提交 / 许可证 / 主语言 / 仓库体积 +
    MCU、主频、仿真平台、工具链静态徽章
    - README 新增「关于」小节：项目定位、实物/仿真双固件、当前版本、范围声明
    - 新增 CHANGELOG.md（Keep a Changelog 格式），记录 v0.0.1 的新增/修复/已知限制
    - 新增 docs/release/v0.0.1.md 作为 Release 正文（能力表、下载资产、快速开始、文档索引）
    - .gitignore 增加 dist/（发布用二进制存放目录）
2026-10-17 chore(license): LICENSE 改为标准 MIT 文本，第三方声明独立成文
    - LICENSE 去掉末尾的中文备注与分隔线，恢复 MIT 标准全文，
    便于 GitHub 的许可证识别器正确匹配（About 侧栏会显示 "MIT license"）
    - 新增 THIRD-PARTY-NOTICES.md：正点原子 CORE/FWLib/SYSTEM/HARDWARE 的
    "仅供学习、禁商用" 声明，以及 ST/ARM/Maxim/江协科技各组件的许可来源
    - README 增加「许可证」章节：MIT 适用范围、第三方边界、商业使用提示
2026-10-17 docs(readme): 徽章 URL 加版本参数，绕过 camo 缓存的旧结果
    GitHub 图片代理会缓存 shields 返回的 SVG，许可证修复前的 'invalid' /
    'not identifiable by github' 一直被沿用。给四个动态徽章加 &v=2 使 URL 变化，
    强制 camo 重新抓取。
2026-10-17 docs(readme): license/language 徽章改静态，去掉不稳定的 last-commit
    shields 的 github/license、github/languages/top 依赖 GitHub API，
    被限流时直接渲染成 invalid；GitHub 的 camo 还会把该结果缓存下来。
    - License 改静态 badge/License-MIT-yellow（不再依赖接口）
    - Language 改静态 badge/language-C
    - 移除 last-commit 徽章（同样受 API 限流影响，仓库 Activity 侧栏已能看到）
2026-10-18 feat(esp32): 信息节点固件 + Web/Android 双端上位机
    - firmware/esp32: Arduino 固件（零第三方库），芯片/网络/运行时/IO 四类采集，
    上行 JSON Lines + 下行 17 条文本命令，串口与设备侧 HTTP 双通路
    - host/gateway: Python 网关（标准库 + pyserial），串口/WiFi/内置模拟器三源可切，
    REST + SSE，串口 3 s 自动重连
    - host/web: 无构建单页面板（四类卡片、三条曲线、扫描表、命令台、原始流）
    - host/app: Java 原生 App（零第三方依赖，APK 30 KB），sw600dp 双列自适应
    - docs/esp32: 架构取舍、协议 v1、调试记录（13 条速查表 + 真机命令回归）
    - scripts/build-esp32.ps1: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
2026-10-18 feat(vitals): 打通 STM32 → ESP32 生理数据链路
    - ESP32: 新增 uart_link（UART2 GPIO16/17），收 STM32 的 JSON 帧并入 telemetry.vitals；
    新增 vitals.status / vitals.sim / vitals.uart / vitals.echo 四条命令；
    坏帧不覆盖旧值，8 s 无帧置 ok=false；GPIO16/17 对 gpio.set 返回 pin_uart
    - STM32: USER/main.c 与 gcc/app/app_main.c 增加自包含 USART1(PA9/PA10) 上行
    （绕开未加入 Keil 工程的 SYSTEM/usart 与 microlib printf 半主机问题），
    每周期发 {"bpm":..,"spo2":..,"temp":..,"fall":..}
    - 网关: vitals 提到 snapshot 顶层，bpm/spo2 并入 series
    - Web/App: 新增「生理数据 · STM32」卡片（心率/血氧/体温/跌倒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
2026-10-18 docs(changelog): v0.2.0 链接改为与 v0.0.1 的对比页（Release 尚未创建，避免死链）
2026-10-18 feat(direct): 设备自包含 HTTP 服务 + App 直连档（MuMu 当真机验收）
    - ESP32: /api/status 与 PC 网关快照同构（source=device，含 60 点环形序列、
    vitals、扫描缓存 + ts）；POST /api/cmd / /api/connect / /api/ports 占位齐了，
    手机连热点 esp32-info-XXXX（12345678，信道 6）后不经过 PC 就能看数据/点引脚/跑扫描
    - ESP32: 开机即 AP_STA —— 之前每次扫描临时切模式会把已连客户端踢下线；
    实测扫描 3.0 s、8 个 AP、客户端不掉线
    - App: 数据源加「直连」档；支持 am start -e url http://192.168.4.1 直达
    - 文档: 协议 §6.1（直连同构快照）、架构 §3.5、调试记录 §5（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
2026-10-30 feat(app): 健康监测 App + 修 ESP32 两个联调缺陷
    - 新增 host/app-vitals：Java 原生、零第三方依赖的生理数据展示 App
    只信 vitals.ok==true，无读数显示「—」而不是 0；四大指标卡 + 90 点心率趋势
    成品 app-vitals.apk（25 KB）随仓库分发，附 build-apk.sh 命令行构建脚本
    - 修 net_info.cpp：Net::ip() 漏判 WIFI_AP_STA，首页不再显示 0.0.0.0
    - 修 uart_link.cpp：bpm=0 的无读数帧不再当有效值，计 invalid 且不刷新 age_ms
    - protocol.md 同步 invalid 字段与实测 ~2 s 帧周期；CHANGELOG/README 升至 v0.3.0
    联调实测：ESP32-D0WD-V3 + vivo V2180GA，~2 s/帧，391 帧里 bad=1（0.25%）
2026-10-30 feat(remote): App 上行 + Basic Auth 中继 + 本地 7 天历史（v0.6.0）
    远程监测方案改为「App 上行 + 账号鉴权 + App 本地历史」，云端仍不落盘。
    - remote/relay_server.py：X-Token 换成 HTTP Basic Auth，上行与下行都校验，
    401 带 WWW-Authenticate，密码比较用 hmac.compare_digest
    - App 侧新增上行（CloudClient：单线程、在途即丢帧、失败节流）与本地历史
    （Store：SQLite 保留 7 天、5 s 降采样、只存有效帧）；设置页新增
    「云端（远程中继）」与「本地历史」两个分组
    - 固件删除 cloud_link：上行改由 App 承担。原实现仍发 X-Token，在新中继上
    必然 401；且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
2026-10-30 fix(remote): 中继兼容 Python 3.6，部署不再要求 3.7+
    CentOS 7 / Alibaba Cloud Linux 3 自带的 python3 是 3.6，原脚本的
    `from __future__ import annotations` 在 3.6 上直接 SyntaxError（future feature
    annotations is not defined），而云服务器上装新版 Python 要么编译、要么换源。
    改动：
    - 去掉 future import，类型注解改为 typing.Dict / typing.Optional
    - 文首补充运行环境说明，README §3.1 标注 3.6+
    行为未变：401 鉴权、POST 覆盖、age_ms 两段相加、age_ms=null 穿透 ok=false 均回归通过。
2026-10-31 feat(remote): 中继透传跌倒报警时间，App 0.0.4 持续报警
    跌倒后手指离开传感器，ok 立刻为 false；旧的上行规则只推有效帧导致最要紧
    的这一帧推不上去。App 侧改为独立报警通道：跌倒期间每 5 s 重推，蓝牙断开也照推，
    并带 fall_ts / fall_ms 两个时间字段。
    中继这边只需要放行字段：VITALS_KEYS 增加 fall_ts、fall_ms，其余逻辑不动
    （报警帧 ok=false，但 fall 仍会透传，查看端据此显示报警时刻）。
    App 源码不在仓库内，APK 见 release v0.0.4。
2026-11-01 docs(changelog): v0.7.1 跌倒改前台弹窗
    App 0.0.5：首次检出跌倒立即弹窗，带报警时间与最近一帧读数；「知道了」只关窗、
    报警继续重发，「停止报警」本轮静默，fall 归 0 自动复位。网页端同步同样规则。
    App 源码不在仓库内，APK 见 release v0.0.5。
2026-11-01 docs(changelog): v0.7.2 跌倒记录前台常驻
    弹窗只打断一次，关掉就没了。记录独立成首页常驻横幅，带报警时刻与进行中/已恢复状态，
    只有用户点「关闭」才清除；fall 归 0 不删记录。App 0.0.6，APK 见 release。
2026-11-01 docs(changelog): v0.7.3 跌倒记录横幅去掉状态文字
    横幅不再区分「进行中 / 已恢复」，只显示报警时刻；跌倒恢复后外观不变，
    仍只有「关闭」能清除。App 0.0.7，APK 见 release。
2026-11-01 docs(changelog): v0.7.4 设置页按连接方式裁剪输入项
    蓝牙档不再显示服务器地址；远程中继档只保留云端一组的地址与账号密码
    （Cfg.readAddr(MODE_REMOTE) 复用 cloud_url）；本地直连不显示云端分组。
    App 0.0.8，APK 见 release。
2026-11-01 docs(app): 新增健康监测 App 界面文档与截图
    - docs/app/README.md：三档链路、设置项与档位的对应关系、跌倒报警规则、
    数据与存储、构建安装、已知限制
    - 三张实机截图（720×1600）：监测面板、跌倒记录横幅、跌倒弹窗
    - 文档内相对链接与图片路径已校验，无断链
2026-11-01 docs: 重构 README 与架构文档结构
    README 由按版本堆叠的开发记录改为面向使用者的结构：目录、简介、界面、
    系统架构、三种连接方式、硬件接线、快速开始、仓库结构、文档索引、
    实测数据、已知限制、许可证、版本说明。
    - 合并「远程监测方案 v0.4.0」与「蓝牙链路 v0.5.0」为「三种连接方式」
    - 修正三处与实现不符的表述：版本口径（原写 v0.3.0）、帧周期（原写每 5 s，
    实为 1.92 s、5 s 滑窗）、跌倒判定（原停留在 AX/AY 增量 500，实为合矢量
    偏差 3072 LSB、判定 87.7 Hz）
    - 新增系统分层图与三档链路图；硬件连线图补 ESP3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
2026-11-01 refactor(host): 网关不再托管静态页面，host/web 下线
    - 删除 host/web（index.html / style.css / app.js）
    - gateway/server.py：移除 WEB_DIR、_static()、mimetypes/webbrowser 依赖与 --no-open 参数；
    根路径返回 404，hint 指向 /api/snapshot 与 /api/events
    - snapshot 的 gateway 段不再包含 web_dir
    - host/README.md 重写：网关、Android 演示 App、健康监测 App、远程中继、数据注入工具；
    远程链路更正为「采集端 App 上行」，原文写成 ESP32 主动 POST 与实现不符
    - docs/esp32 与 firmware/esp32/README 同步：目录树、分层图、能力表去掉 host/web
    与面板相关表述；protocol.md 的「不跑 Web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
2026-11-01 docs(schematic): 原理图升级为 v1.1 并入库
    README、board/schematic.md、docs/architecture.md 均已引用 v1.1，但改名此前只暂存、
    未提交，导致远端 main 上这七处链接全部指向不存在的文件。
    - 新增 docs/schematic/系统原理图_v1.1.md 与 .svg：加入 ESP32 信息节点
    （PA9/PA10 ↔ GPIO16/17）、逐引脚标注、3.3 V / GND 母线与 DS18B20 上拉
    - 删除 v1.0 同名文件
    - docs/release/v0.0.1.md 的原理图链接改为 v1.1，并注明发布时为 v1.0
2026-11-01 chore: 清理无引用的图片与发布说明
    - 删除 docs/debug/06-oled_业务界面还原.png（06 报告正文无引用）
    - 删除 docs/esp32/app-mumu-wifi.png（README 改版后无引用）
    - 删除 docs/release/v0.0.1.md（全仓库无链接，v0.0.1 正文仍在 GitHub Release 上）
    - 清空 firmware/MAX30102/OBJ 下的三份 Keil 残留（build_log / sct / dep，无 hex）
    删除后仓库内全部图片均被至少一份文档引用，相对链接无死链。
2026-11-03 docs: 齿轮入口改为【设置】
