PandaGuGu/stm32-health-monitor/(notices)

Notices in the files:
firmware/MAX30102_sim/SYSTEM/timer/timer.h:
Copyright(C) ¹ãÖÝÊÐÐÇÒíµç×Ó¿Æ¼¼ÓÐÏÞ¹«Ë¾ 2014-2024
All rights reserved
